SRT31/high-speed-camera-system/poster/fps_vs_height.csv

H | fps
64 | 975
75 | 930
80 | 864
96 | 771
112 | 692
128 | 618
144 | 574
160 | 491
176 | 484
192 | 455
208 | 417
224 | 400
240 | 372
256 | 353
272 | 333
288 | 314
304 | 298
320 | 269
480 | 180
