SRT31/high-speed-camera-system/poster/fps_vs_height_table.png

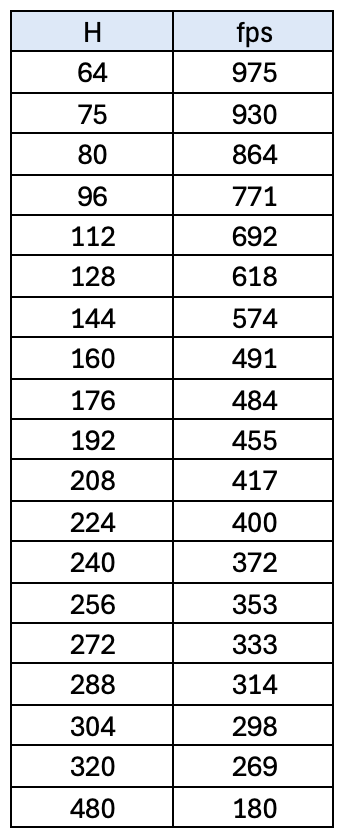
poster/fps_vs_height_table.png
