SRT31/high-speed-camera-system/Prototype documentation/PCB_PCB_PHOTOPOLYMER_CURE_LIGHT_V0_0_2025-07-21.png

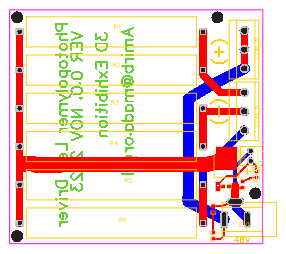
Prototype documentation/PCB_PCB_PHOTOPOLYMER_CURE_LIGHT_V0_0_2025-07-21.png
