SRT31/high-speed-camera-system/Prototype documentation/PCB_PCB_Shield_Amir_ELAD_V_0_0_2025-07-21.png

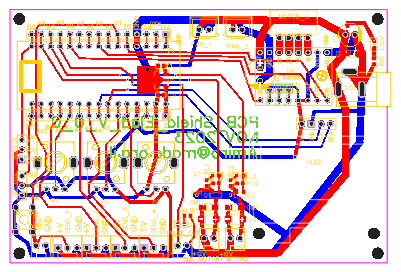
Prototype documentation/PCB_PCB_Shield_Amir_ELAD_V_0_0_2025-07-21.png
