SRT31/high-speed-camera-system/sharp.gif

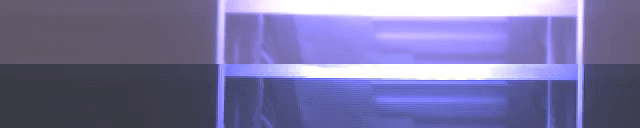
sharp.gif
