SRT31/high-speed-camera-system/Prototype documentation/Schematic_Drop_sensor_2025-07-21.pdf

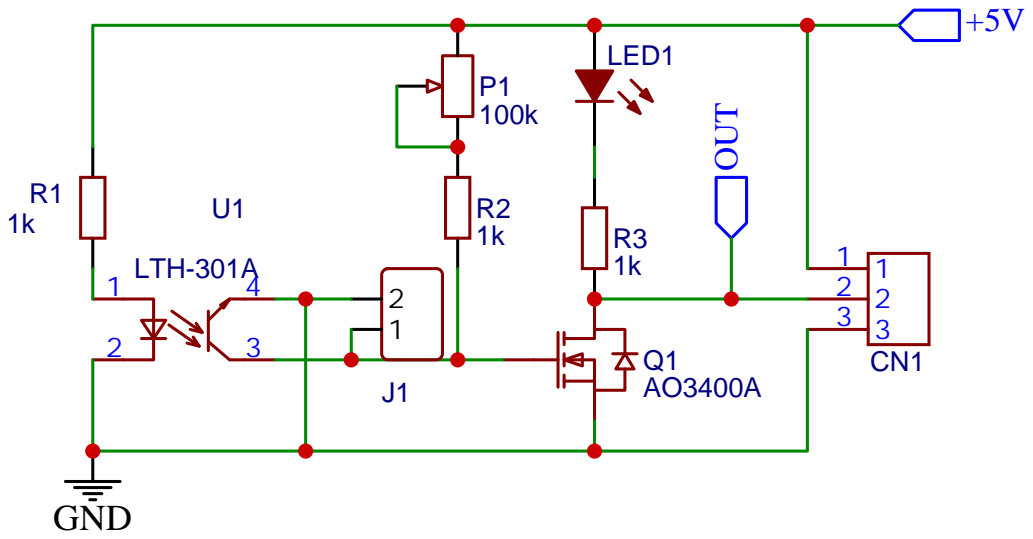
[picture p20: page 1]

Drop_sensor for water drop screen and/or UV cure exhebit REV: 1.0
