SRT31/high-speed-camera-system/Prototype documentation/Schematic_PHOTOPOLYMER_CURE_LIGHT_V0_0_2025-07-21 (1).pdf

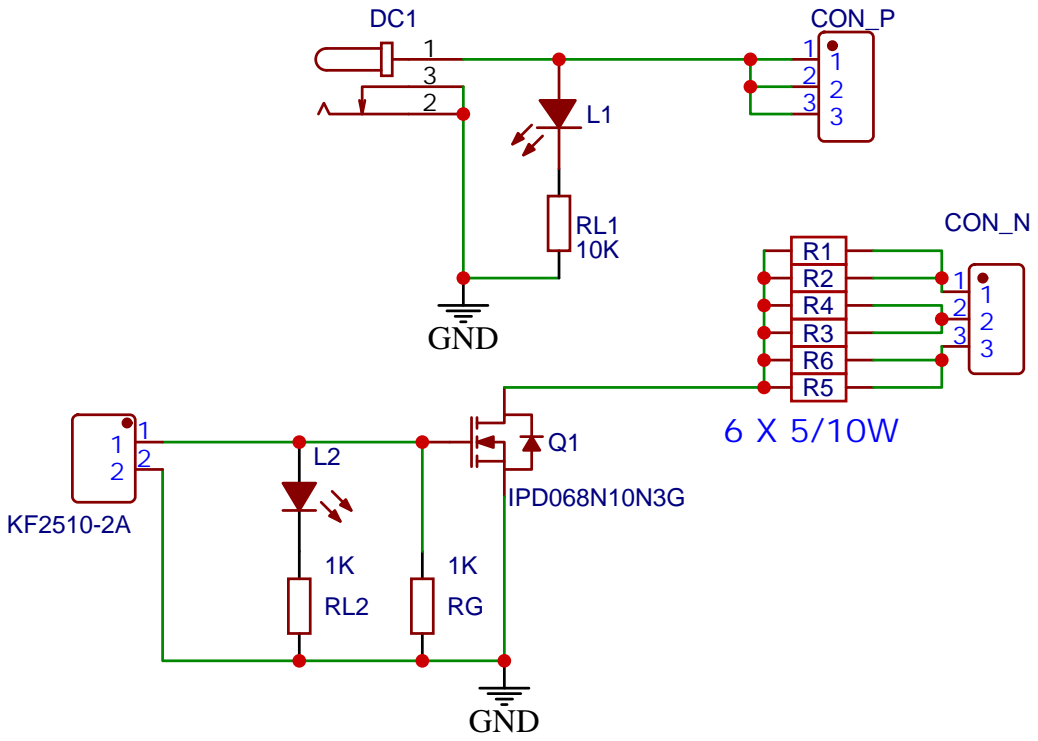
[picture p21: page 1]
