SRT31/high-speed-camera-system/Prototype documentation/PCB_PCB_Drop_sensor_2_2025-07-21.pdf

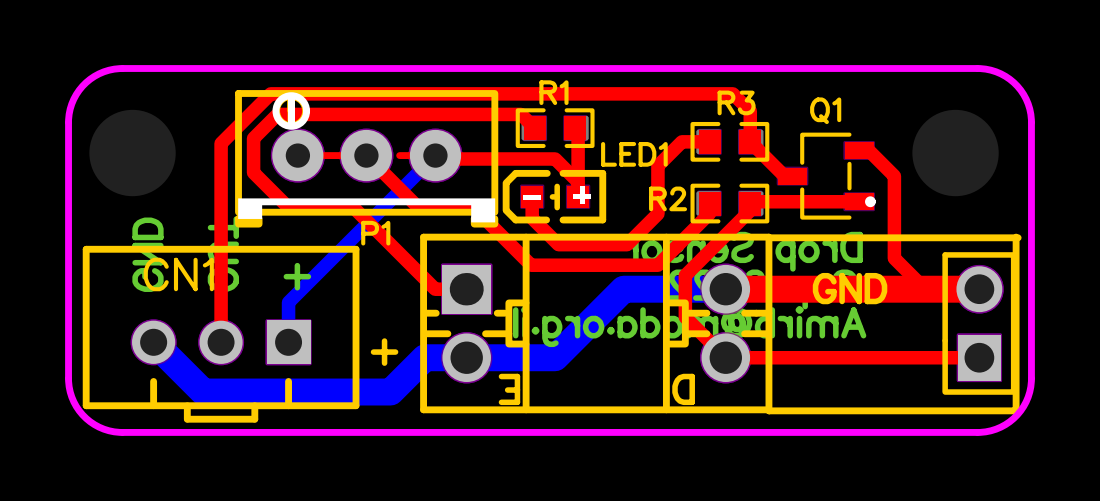
[picture p22: page 1]
