SRT31/high-speed-camera-system/connecting-pi-arduino/test_input.py

import RPi.GPIO as GPIO
import time

PIN = 17  # BCM GPIO for capture trigger from Arduino

GPIO.setmode(GPIO.BCM)
GPIO.setup(PIN, GPIO.IN, pull_up_down=GPIO.PUD_DOWN)

print("Testing GPIO input... Touch pin to 3.3V to simulate HIGH.")
try:
    while True:
        if GPIO.input(PIN):
            print("HIGH detected!")
        else:
            print("LOW")
        time.sleep(0.5)
except KeyboardInterrupt:
    print("Exiting")
finally:
    GPIO.cleanup()
